qwattash/keyboard_tester/README.md

# Components for testing an early prototype RGB backlit keyboard

The design is based on the atmega32u4 MCU, found on teensey boards and arduino Leonardo boards, and an ISSI 3733 led driver that can drive leds for half of a full-size keyboard.
