qwattash/keyboard_tester/components/cherry_breakout_2u_plate.step

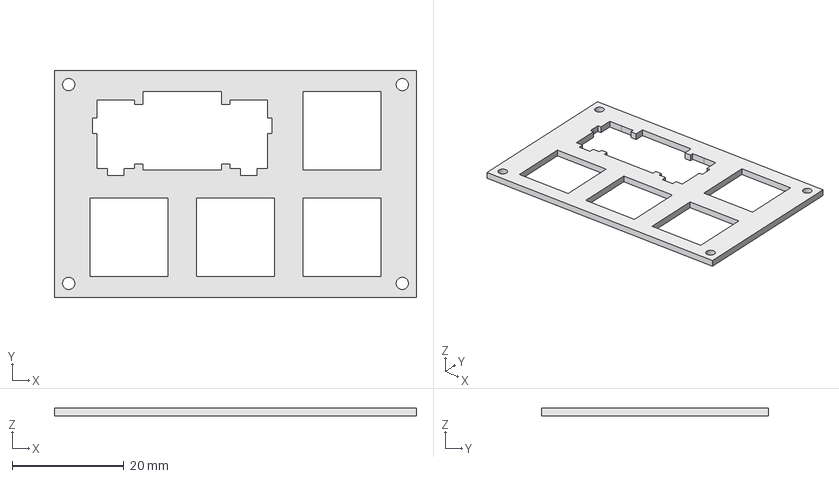
[picture p1: CAD file, 2018-07-26]
components/cherry_breakout_2u_plate.step
64.8 x 40.6 x 1.50 mm
