qwattash/keyboard_tester/(list of files, cad)

Other CAD files:
components/cherry_breakout_2u_plate.fcstd
