qwattash/keyboard_tester/pcb/cherry_proto_circuit/cherry_proto_circuit.pdf

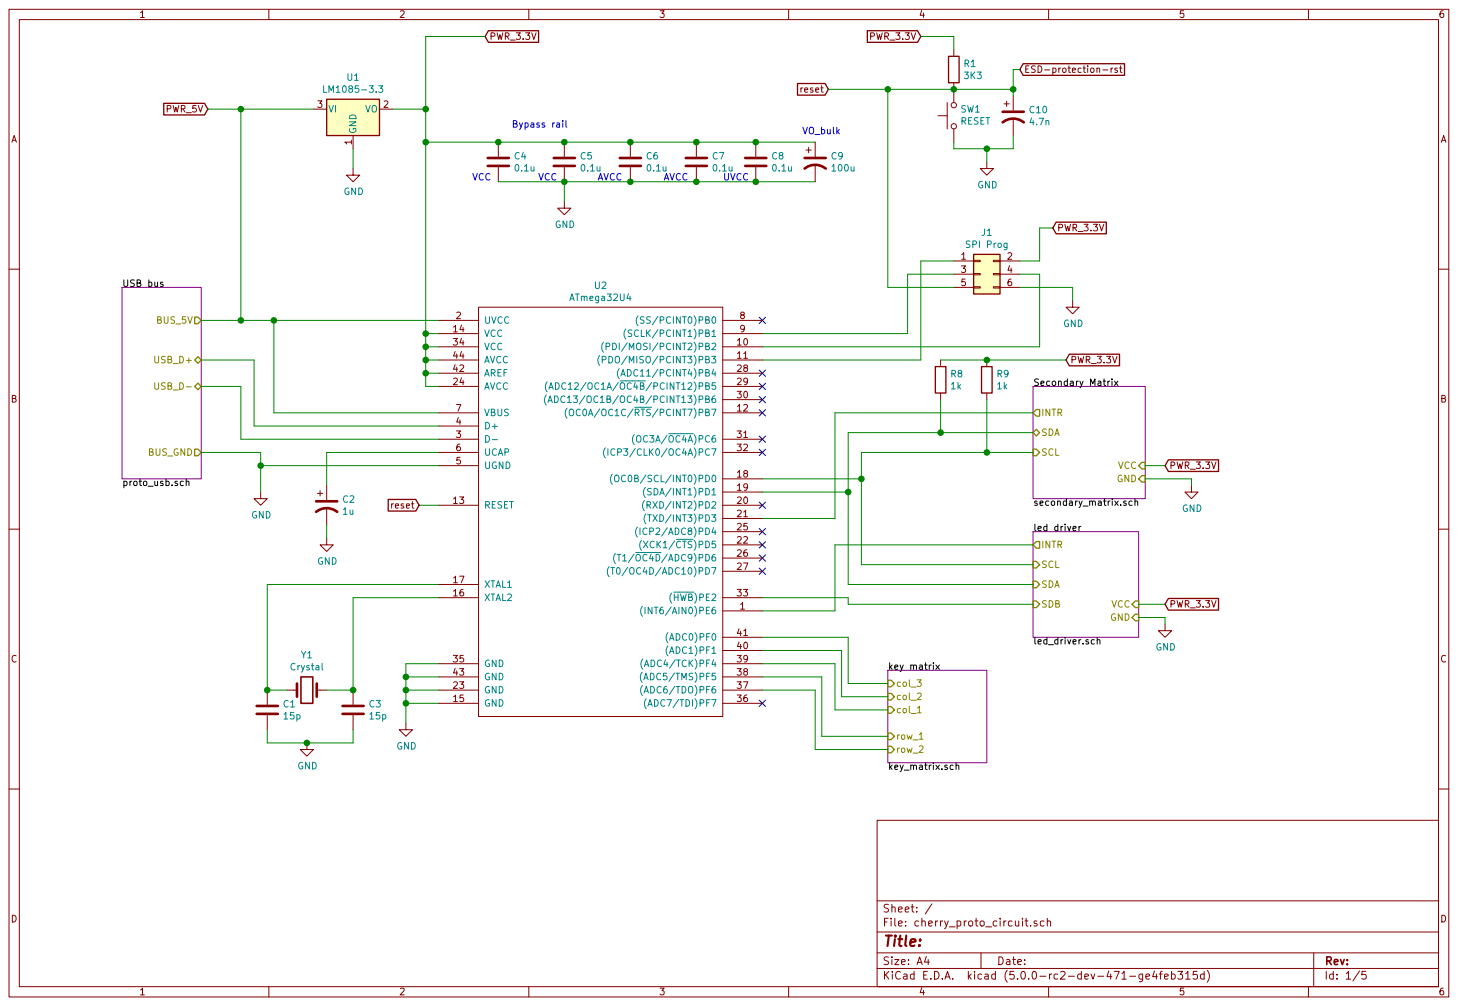
[picture p2: page 1]

Bypass rail GND GND

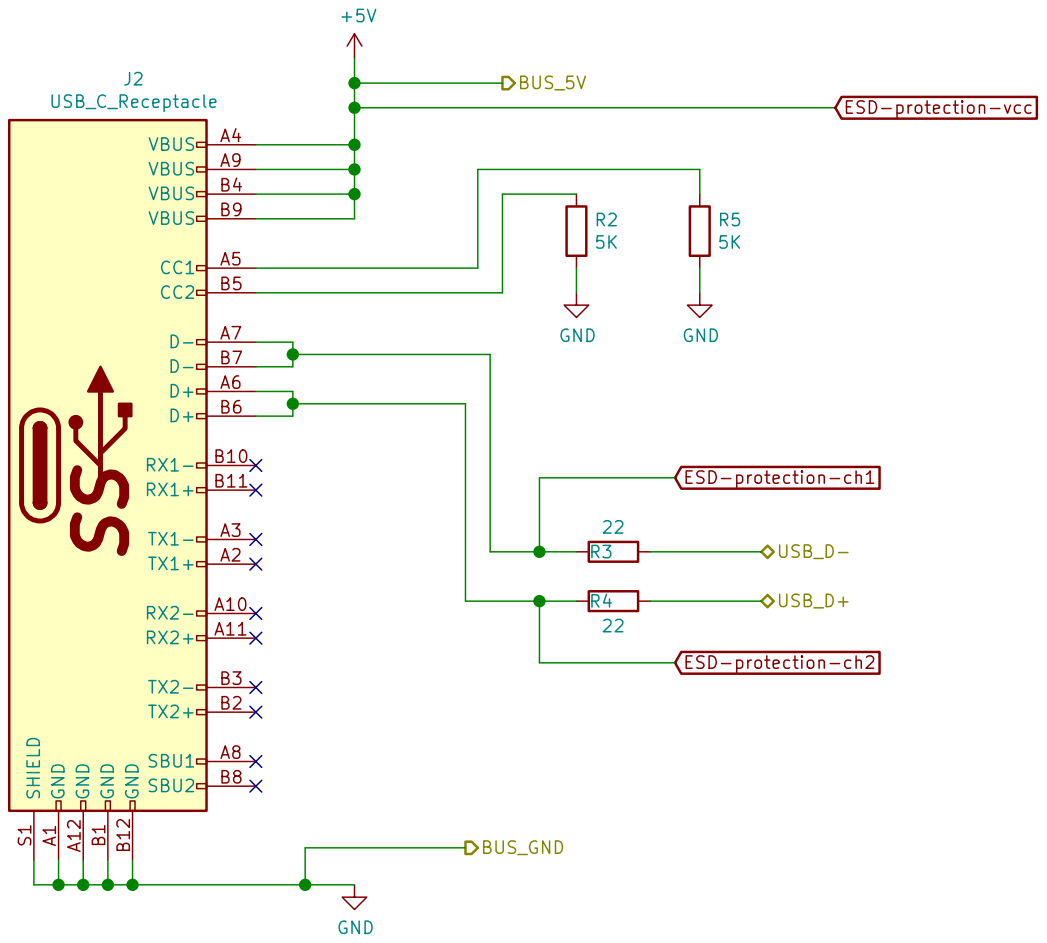
[picture p3: page 2]

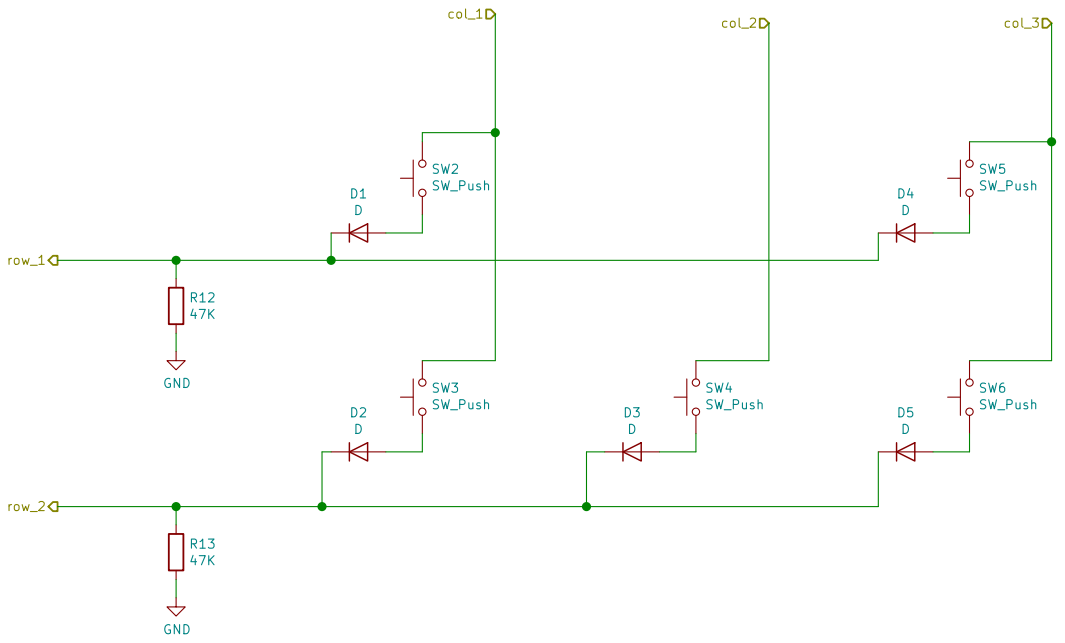
[picture p4: page 3]

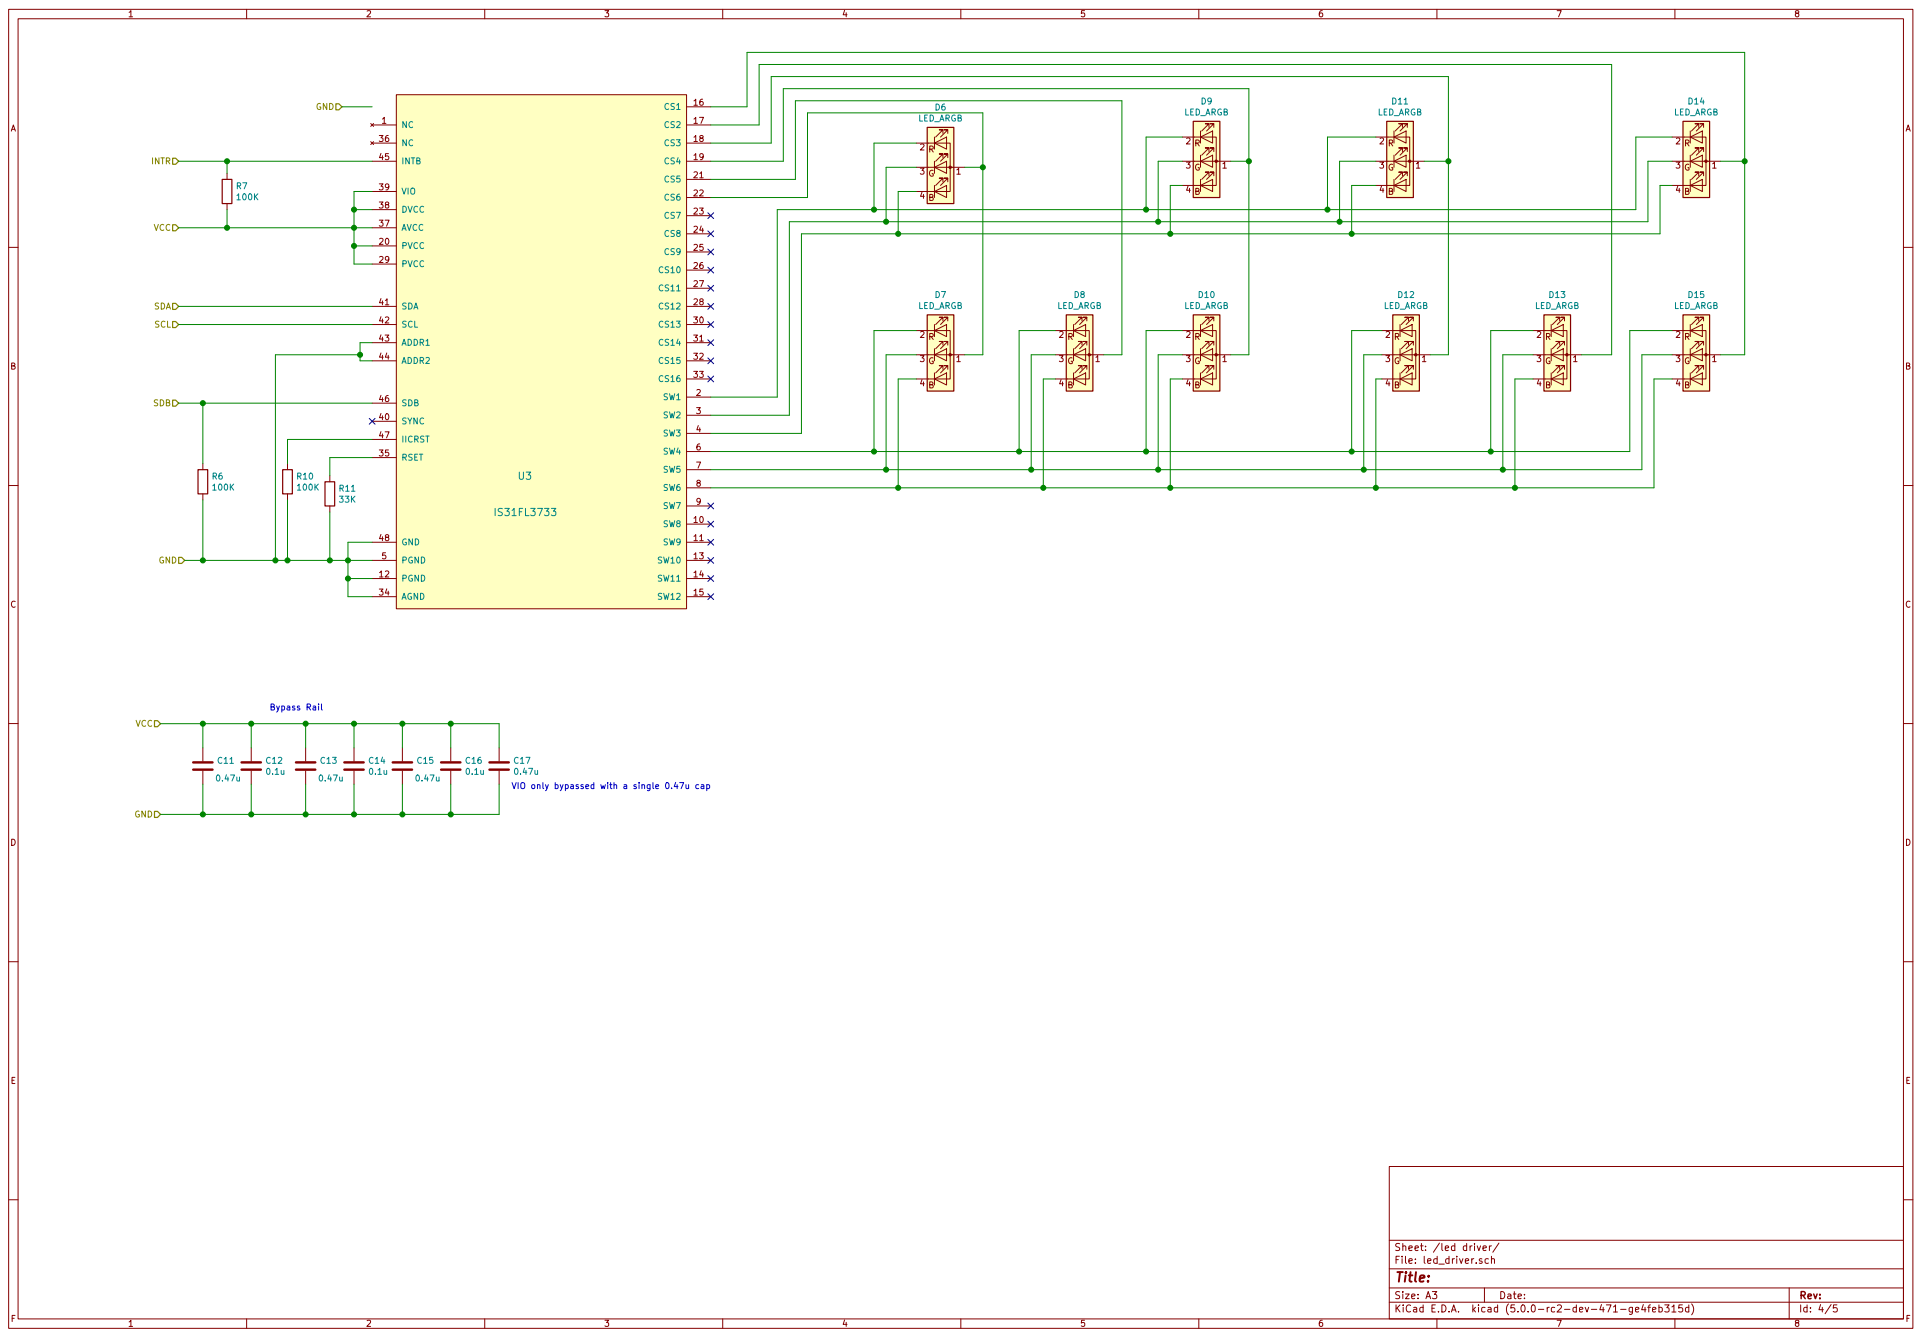
[picture p5: page 4]

Id: 4/5 Title: File: led_driver.sch Sheet: /led driver/

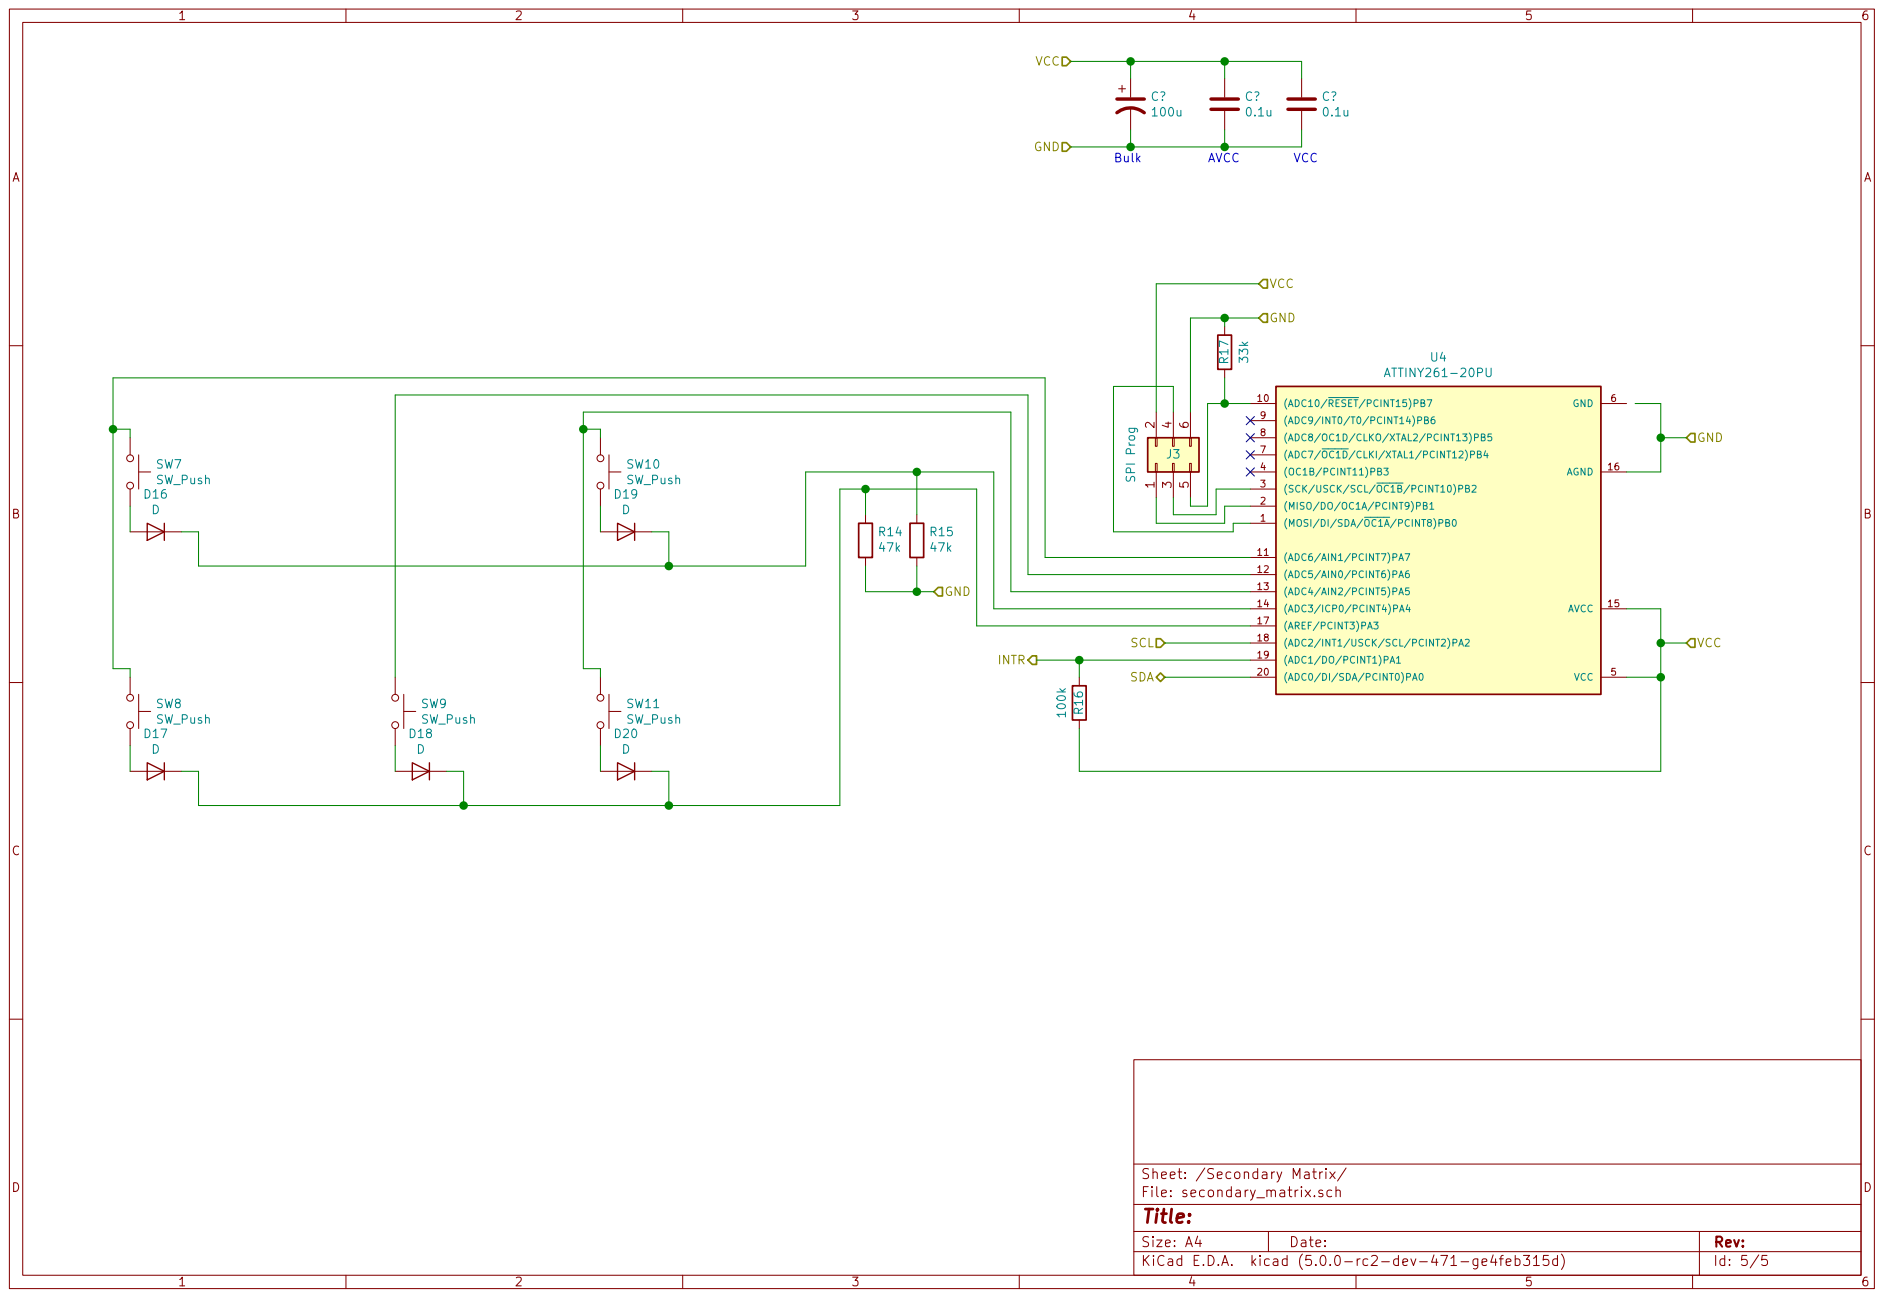
[picture p6: page 5]

Sheet: /Secondary Matrix/ SDA
