qwattash/keyboard_tester/pcb/cherry_proto_circuit/schematic.pdf

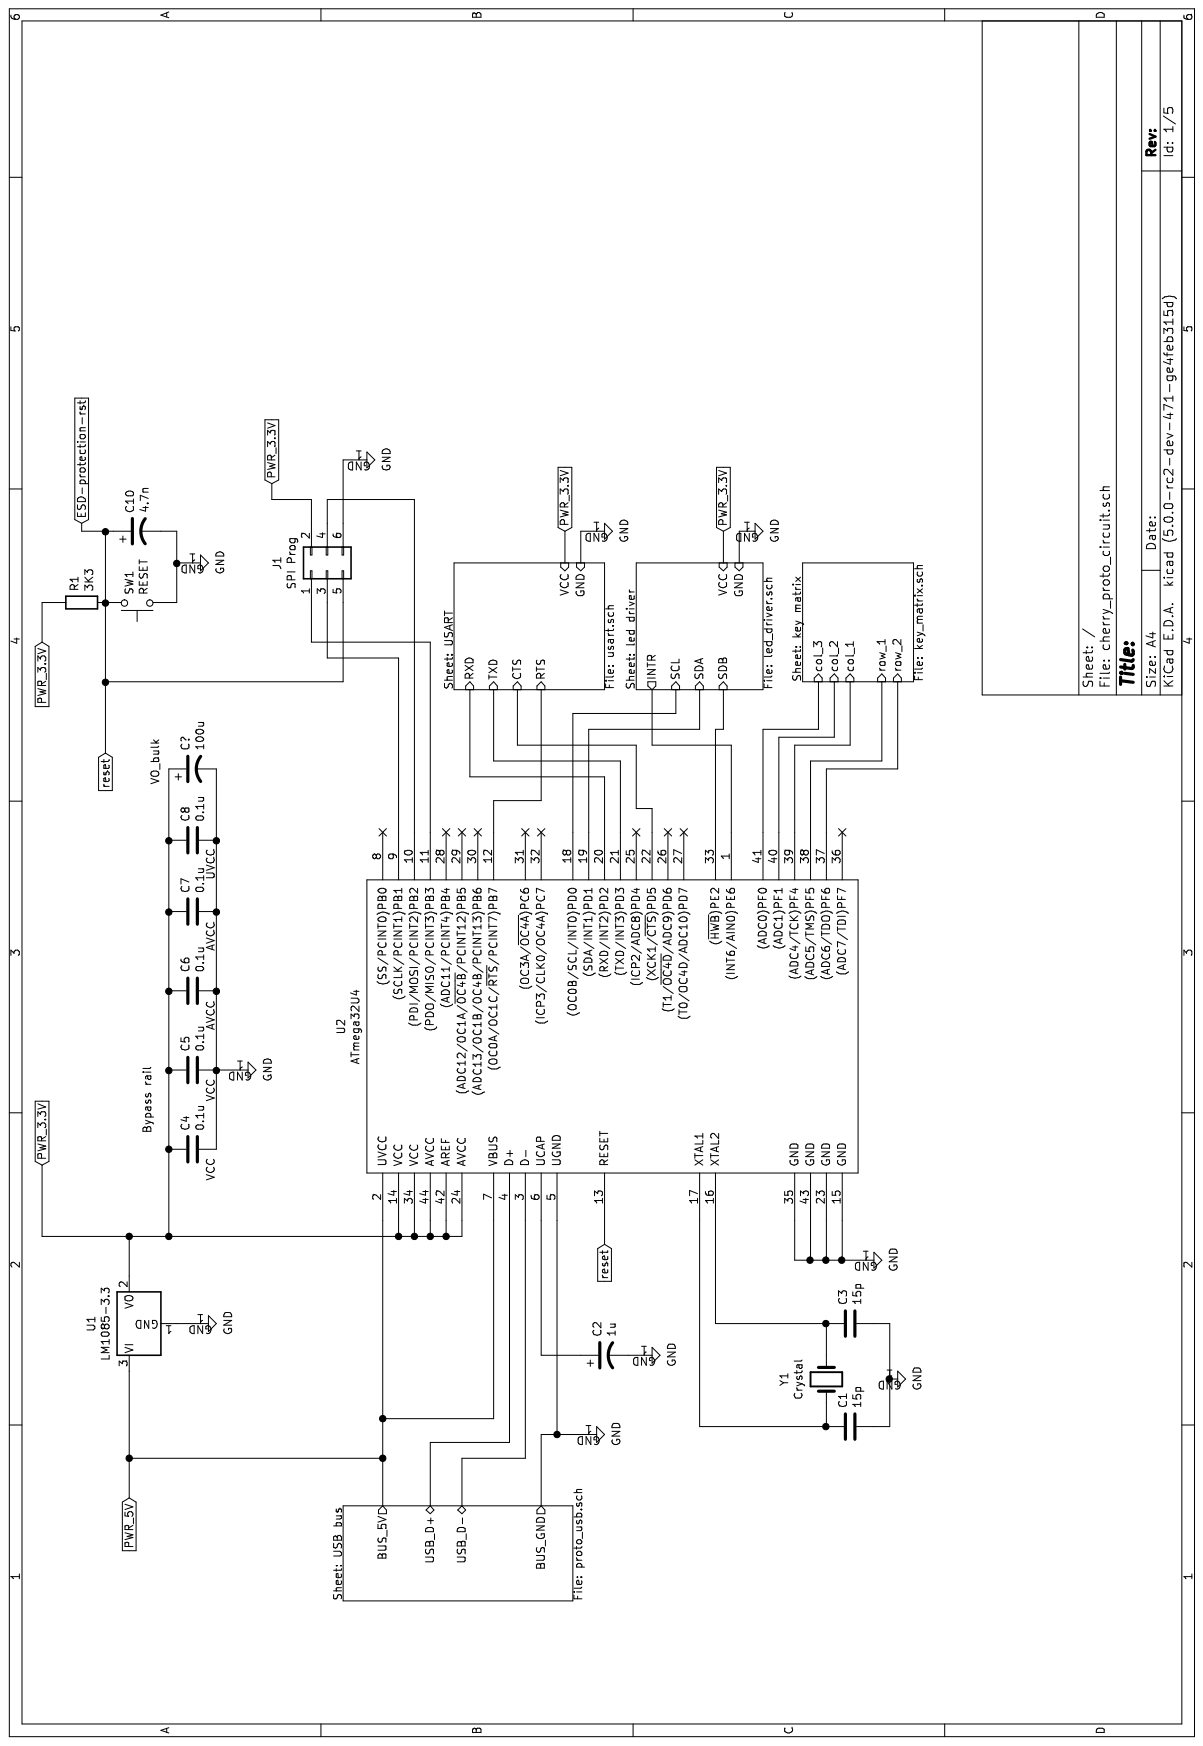
[picture p7: page 1]

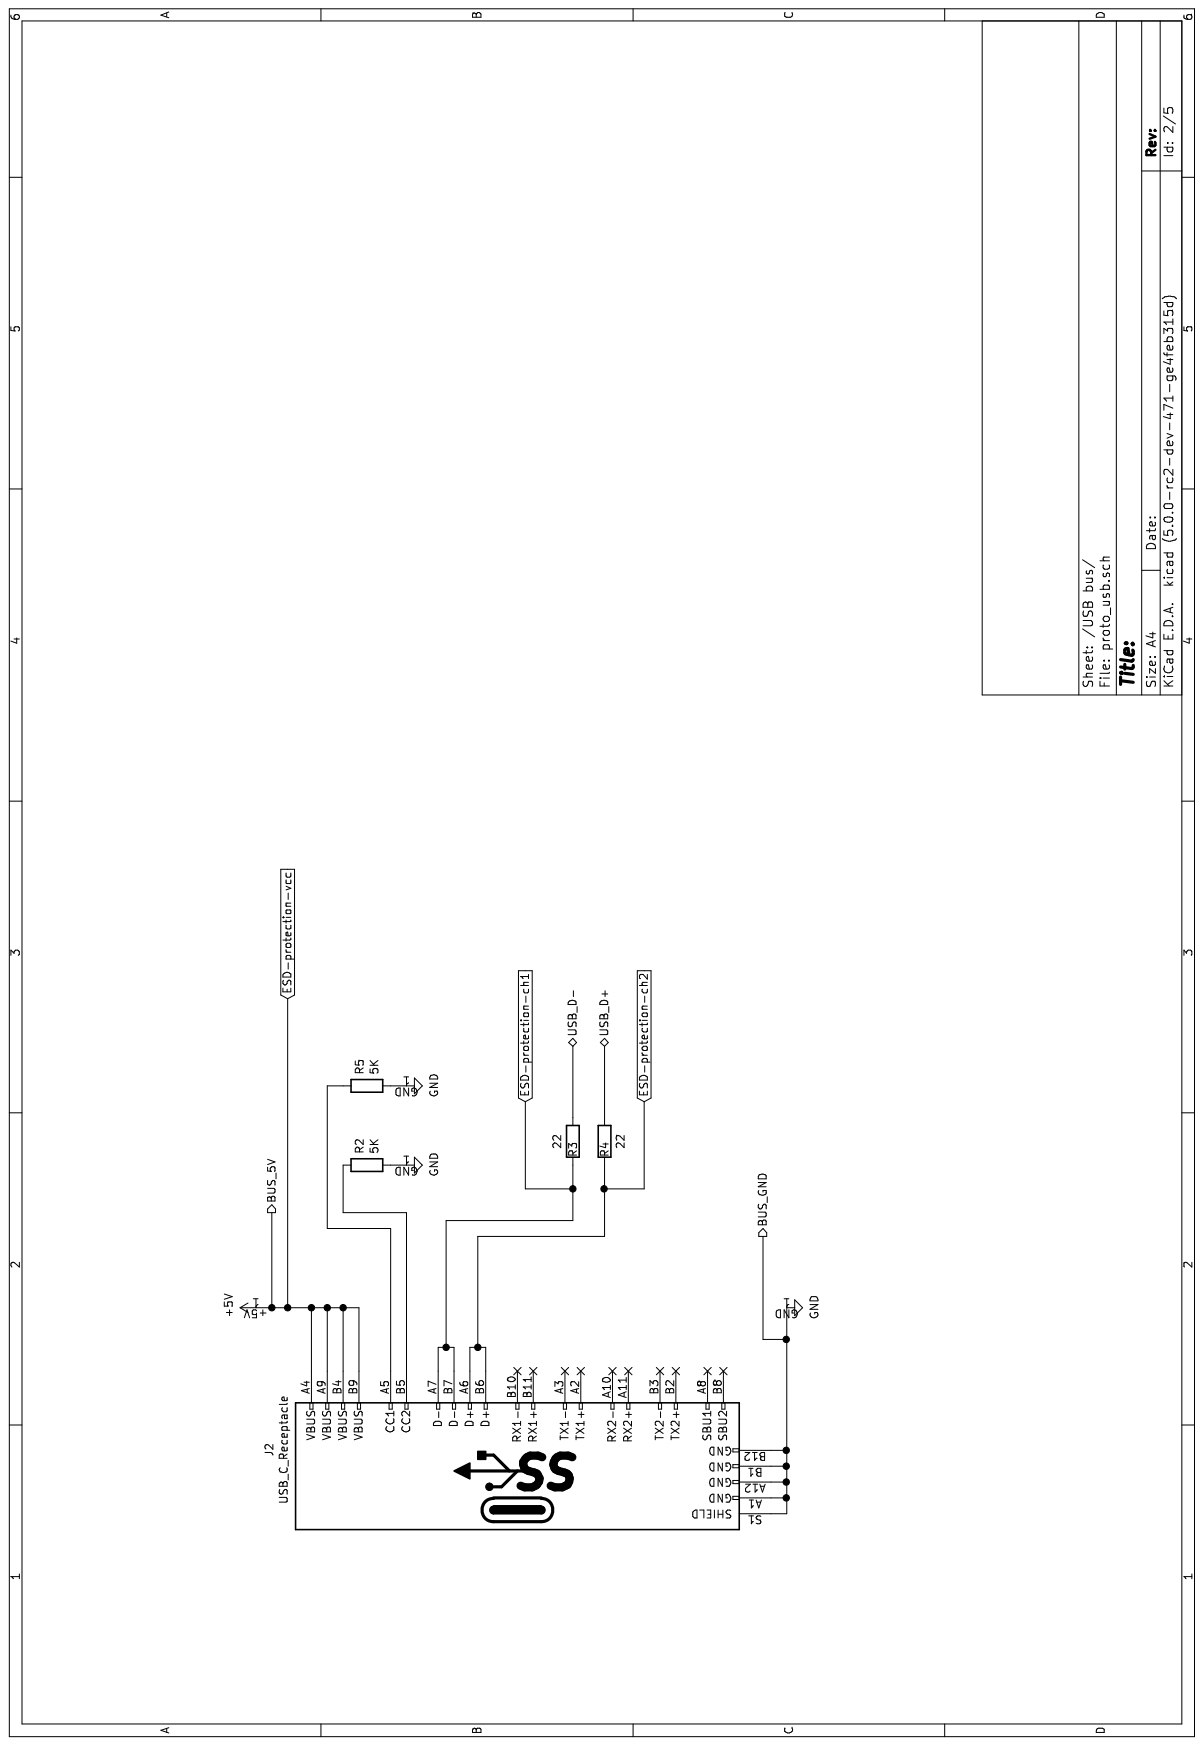
[picture p8: page 2]

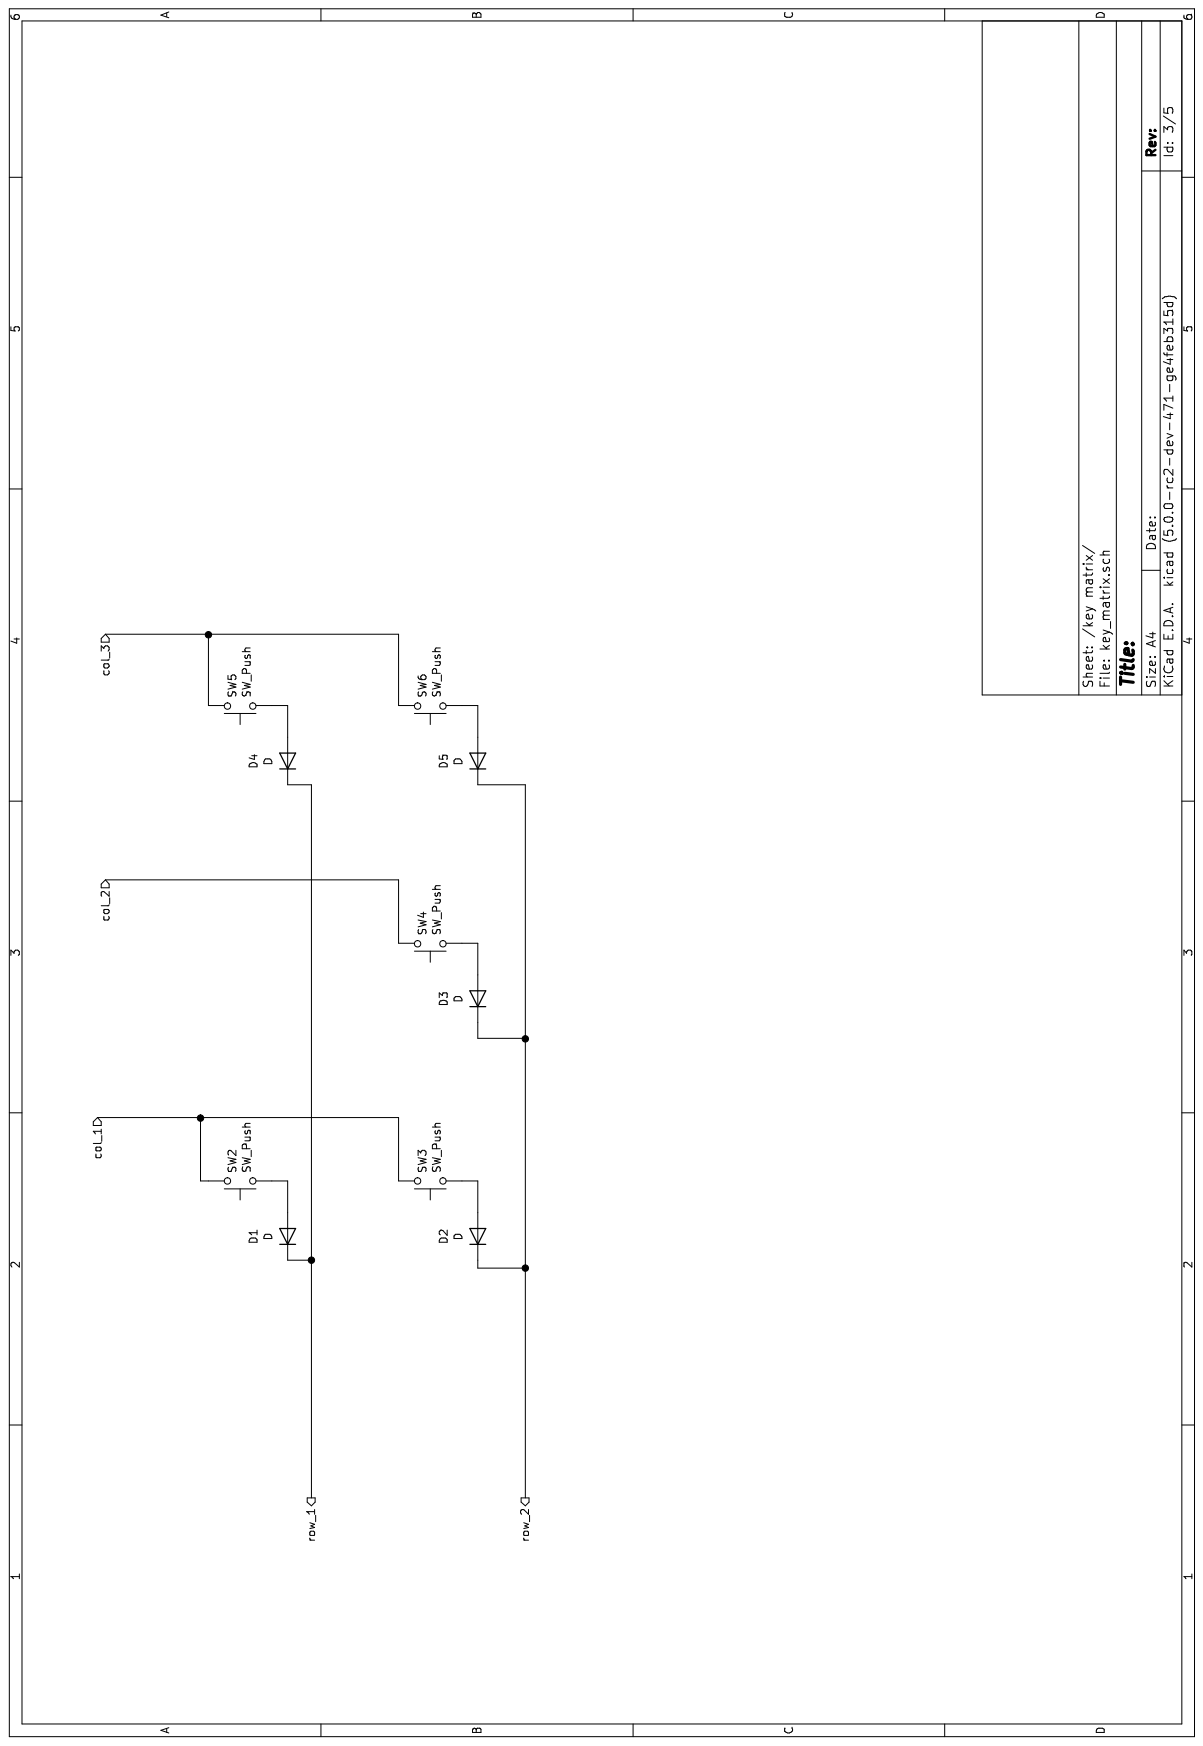
[picture p9: page 3]

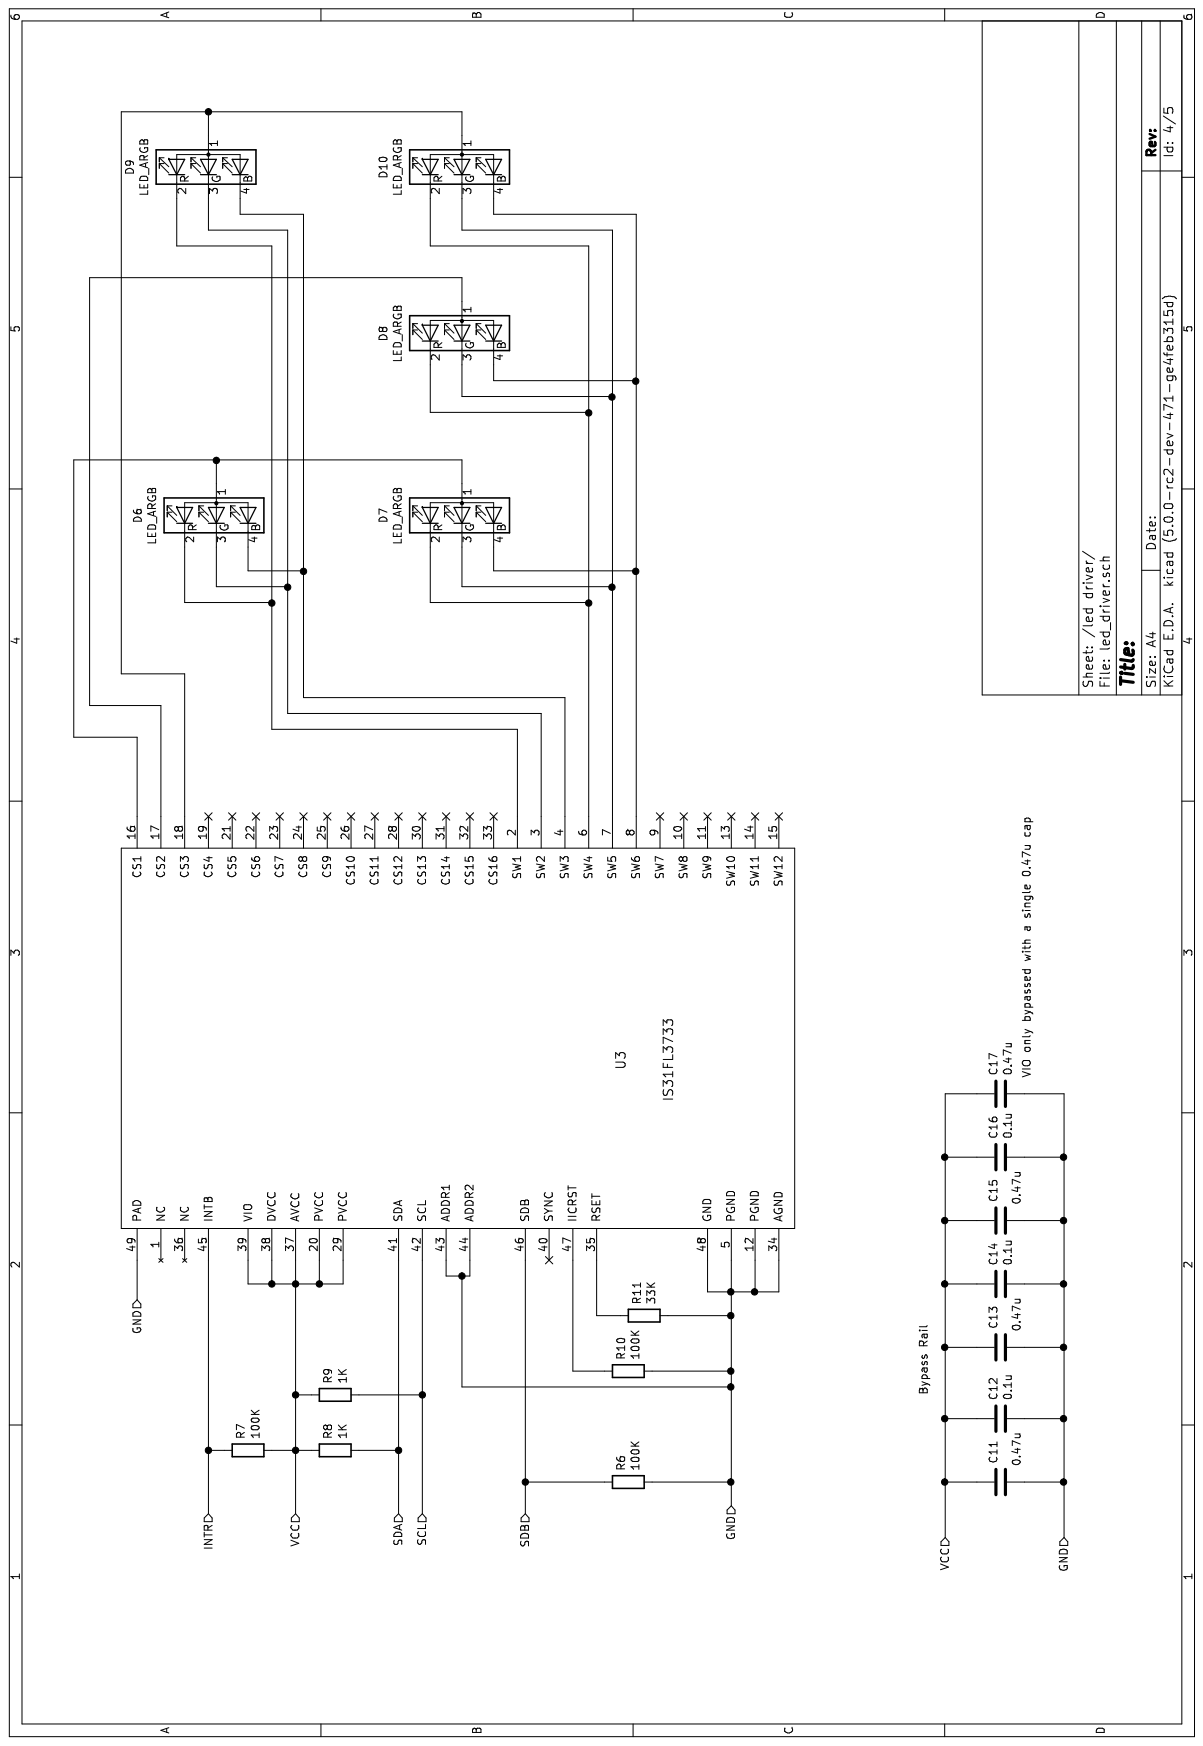
[picture p10: page 4]

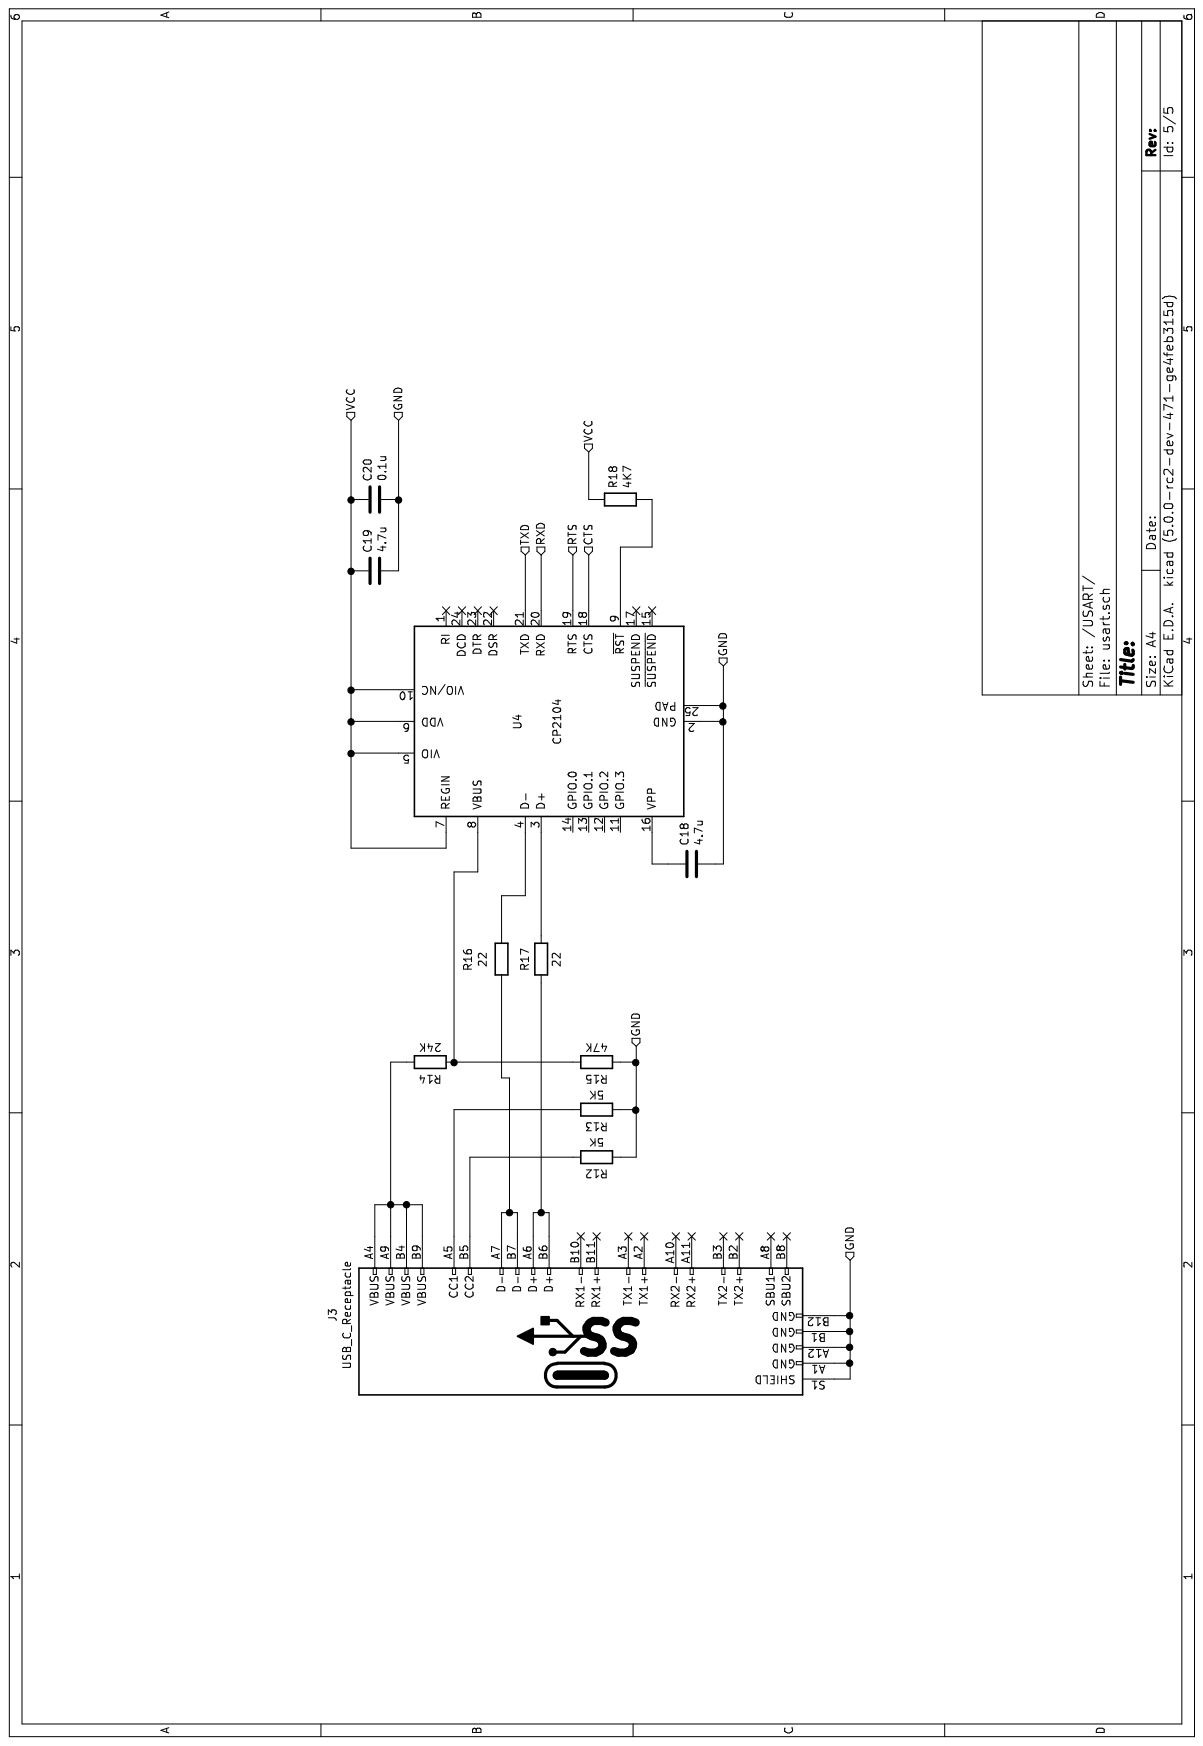
[picture p11: page 5]
