qwattash/keyboard_tester/pcb/cherry_breakout2u/cherry_breakout_2u_double_side.kicad_pcb

## KiCad design pcb/cherry_breakout2u/cherry_breakout_2u_double_side.kicad_pcb (2018-07-26)

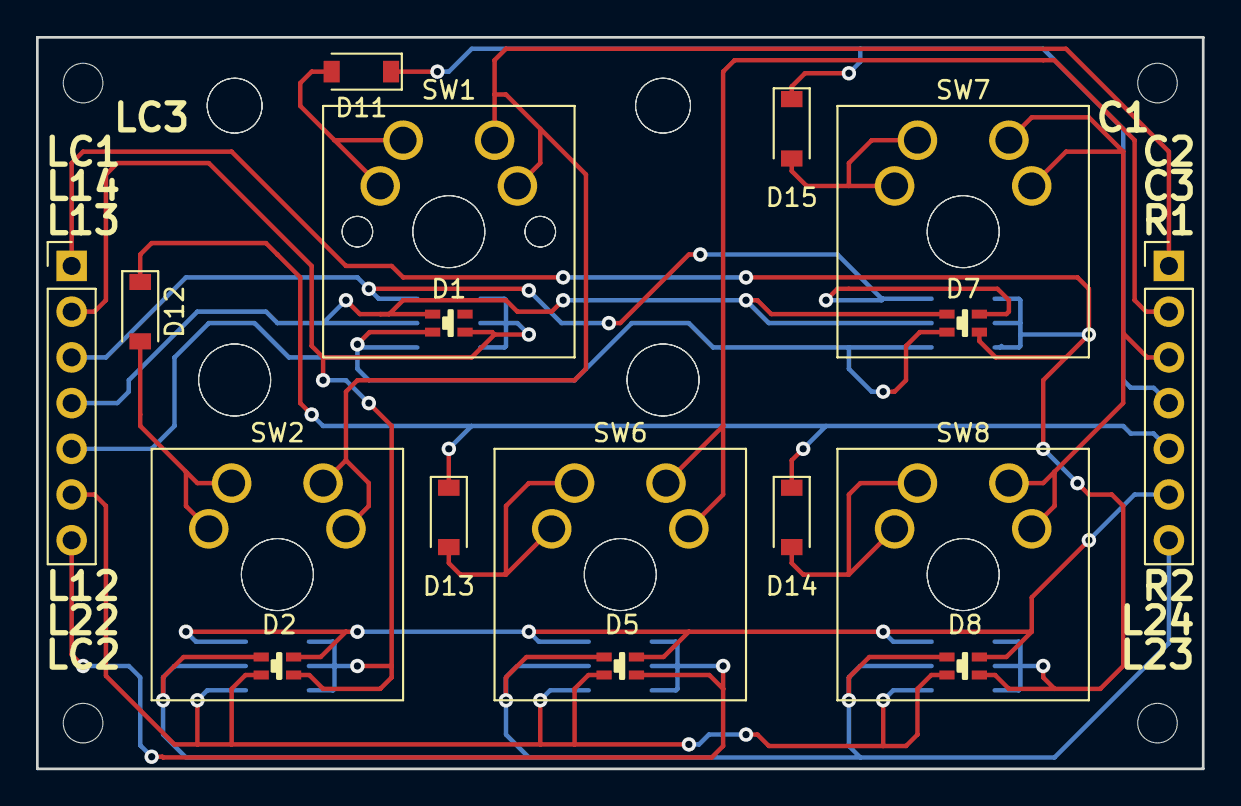
[picture p12: board cherry_breakout_2u_double_side.kicad_pcb from above]

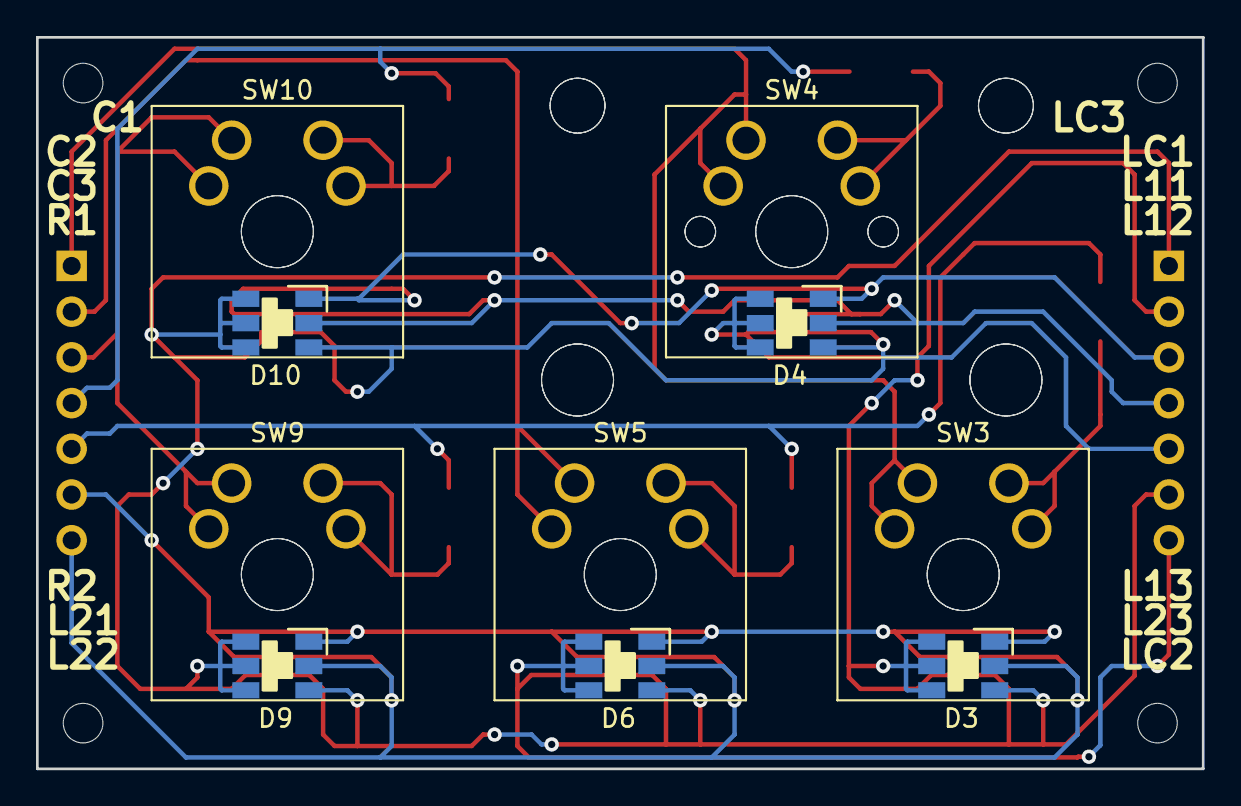
[picture p13: board cherry_breakout_2u_double_side.kicad_pcb from below]

Board: 2 copper layers, 64.8 x 40.6 mm, 27 parts (10 on the bottom side), 19 nets.

Parts:
D1: LED_A; Led_SMD_0606
D2: LED_C; Led_SMD_0606
D3: LED_Cb; LED_smd_1214
D4: LED_Ab; LED_smd_1214
D5: LED_D; Led_SMD_0606
D6: LED_Db; LED_smd_1214
D7: LED_B; Led_SMD_0606
D8: LED_E; Led_SMD_0606
D9: LED_Eb; LED_smd_1214
D10: LED_Bb; LED_smd_1214
D11: D_A; D_SOD-123
D12: D_C; D_SOD-123
D13: D_D; D_SOD-123
D14: D_E; D_SOD-123
D15: D_B; D_SOD-123
J1: ConnLeft; Pin_Header_Straight_1x07_Pitch2.54mm
J2: ConnRight; Pin_Header_Straight_1x07_Pitch2.54mm
SW1: A; SW_Cherry_MX1A_2.00u_PCB
SW2: C; SW_Cherry_MX1A_1.00u_Plate
SW3: Cb; SW_Cherry_MX1A_1.00u_Plate
SW4: Ab; SW_Cherry_MX1A_2.00u_PCB
SW5: Db; SW_Cherry_MX1A_1.00u_Plate
SW6: D; SW_Cherry_MX1A_1.00u_Plate
SW7: B; SW_Cherry_MX1A_1.00u_Plate
SW8: E; SW_Cherry_MX1A_1.00u_Plate
SW9: Eb; SW_Cherry_MX1A_1.00u_Plate
SW10: Bb; SW_Cherry_MX1A_1.00u_Plate

Connections:
unnamed: D1.1, D2.1, D3.4, D3.5, D3.6, D4.4, D4.5, D4.6, J1.2
unnamed: D1.2, D4.3, D7.2, D10.3, J1.5
unnamed: D1.3, D4.2, D7.3, D10.2, J1.4
unnamed: D1.4, D4.1, D7.4, D10.1, J1.3
unnamed: D2.2, D3.3, D5.2, D6.3, D8.2, D9.3, J1.6
unnamed: D2.3, D3.2, D5.3, D6.2, D8.3, D9.2, J2.7
unnamed: D2.4, D3.1, D5.4, D6.1, D8.4, D9.1, J2.6
unnamed: D5.1, D6.4, D6.5, D6.6, J1.7
unnamed: D7.1, D8.1, D9.4, D9.5, D9.6, D10.4, D10.5, D10.6, J1.1
unnamed: D11.1, D15.1, J2.4
unnamed: D11.2, SW1.2, SW4.1
unnamed: D12.1, D13.1, D14.1, J2.5
unnamed: D12.2, SW2.2, SW3.1
unnamed: D13.2, SW5.1, SW6.2
unnamed: D14.2, SW8.2, SW9.1
unnamed: D15.2, SW7.2, SW10.1
unnamed: J2.1, SW1.1, SW2.1, SW3.2, SW4.2
unnamed: J2.2, SW5.2, SW6.1
unnamed: J2.3, SW7.1, SW8.1, SW9.2, SW10.2
