qwattash/keyboard_tester/pcb/cherry_breakout/cherry_breakout.kicad_pcb

## KiCad design pcb/cherry_breakout/cherry_breakout.kicad_pcb (2018-07-26)

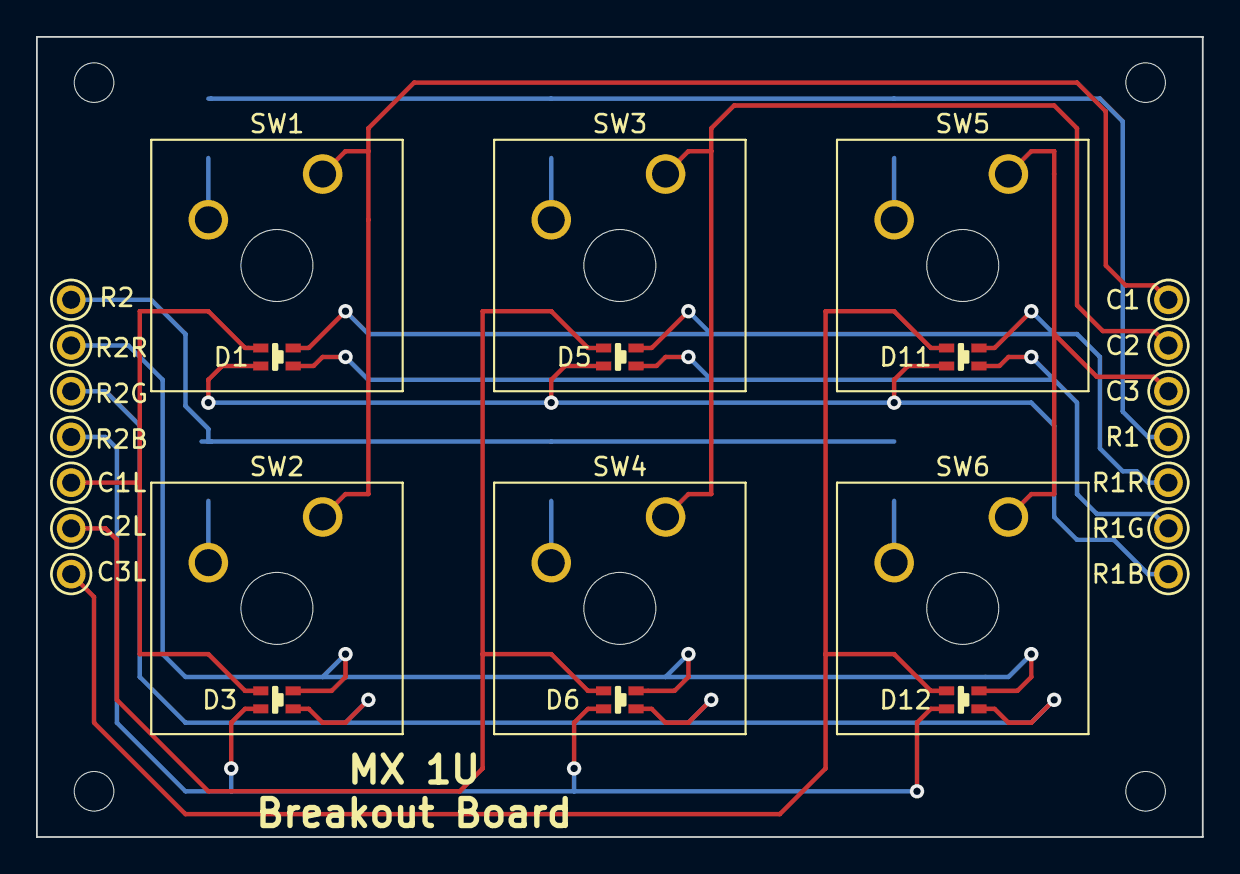
[picture p14: board cherry_breakout.kicad_pcb from above]

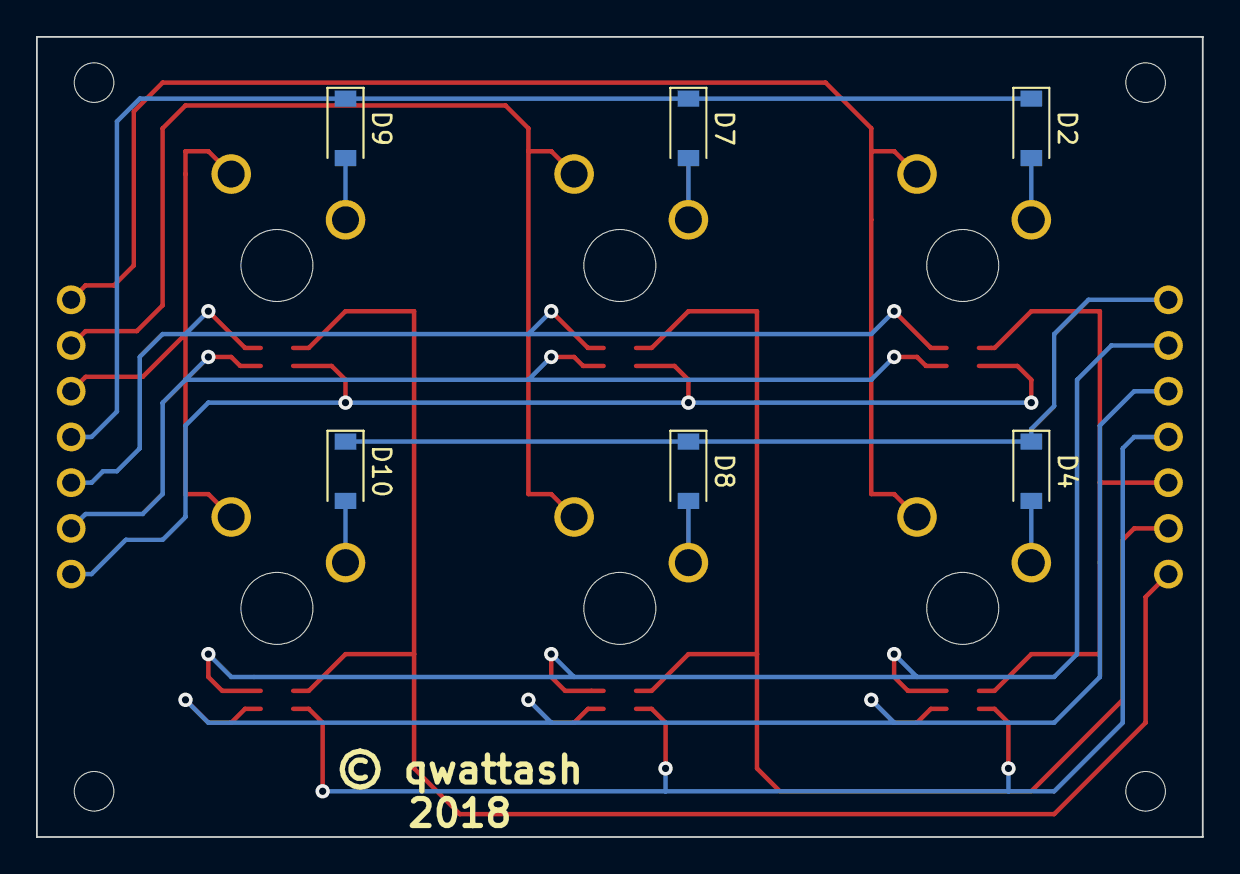
[picture p15: board cherry_breakout.kicad_pcb from below]

Board: 2 copper layers, 64.8 x 44.5 mm, 32 parts (6 on the bottom side), 20 nets.

Parts:
C1: Col1; Connector_Via_1.0mm
C1L: LCol1; Connector_Via_1.0mm
C2: Col2; Connector_Via_1.0mm
C2L: LCol2; Connector_Via_1.0mm
C3: Col3; Connector_Via_1.0mm
C3L: LCol3; Connector_Via_1.0mm
D1: LED_11; Led_SMD_0606
D2, D4, D7, D8, D9, D10: D_ALT; D_SOD-123
D3: LED_21; Led_SMD_0606
D5: LED_12; Led_SMD_0606
D6: LED_22; Led_SMD_0606
D11: LED_13; Led_SMD_0606
D12: LED_23; Led_SMD_0606
R1: Row 1; Connector_Via_1.0mm
R1B: LRow1B; Connector_Via_1.0mm
R1G: LRow1G; Connector_Via_1.0mm
R1R: LRow1R; Connector_Via_1.0mm
R2: Row 2; Connector_Via_1.0mm
R2B: LRow2B; Connector_Via_1.0mm
R2G: LRow2G; Connector_Via_1.0mm
R2R: LRow2R; Connector_Via_1.0mm
SW1: SW11; SW_Cherry_MX1A_1.00u_Plate
SW2: SW21; SW_Cherry_MX1A_1.00u_Plate
SW3: SW12; SW_Cherry_MX1A_1.00u_Plate
SW4: SW22; SW_Cherry_MX1A_1.00u_Plate
SW5: SW13; SW_Cherry_MX1A_1.00u_Plate
SW6: SW23; SW_Cherry_MX1A_1.00u_Plate

Connections:
unnamed: C1L.1, D1.1, D3.1
unnamed: D1.2, D5.2, D11.2, R1R.1
unnamed: D1.3, D5.3, D11.3, R1G.1
unnamed: D1.4, D5.4, D11.4, R1B.1
unnamed: D2.1, D7.1, D9.1, R1.1
unnamed: D2.2, SW1.2
unnamed: D4.2, SW2.2
unnamed: C2L.1, D5.1, D6.1
unnamed: D7.2, SW3.2
unnamed: D8.2, SW4.2
unnamed: D9.2, SW5.2
unnamed: D4.1, D8.1, D10.1, R2.1
unnamed: D10.2, SW6.2
unnamed: C3L.1, D11.1, D12.1
unnamed: D3.2, D6.2, D12.2, R2R.1
unnamed: D3.3, D6.3, D12.3, R2G.1
unnamed: D3.4, D6.4, D12.4, R2B.1
unnamed: C1.1, SW1.1, SW2.1
unnamed: C2.1, SW3.1, SW4.1
unnamed: C3.1, SW5.1, SW6.1
