qwattash/keyboard_tester/pcb/tqfp44-48_breakout/tqfp44-48_breakout.kicad_pcb

## KiCad design pcb/tqfp44-48_breakout/tqfp44-48_breakout.kicad_pcb (2018-07-26)

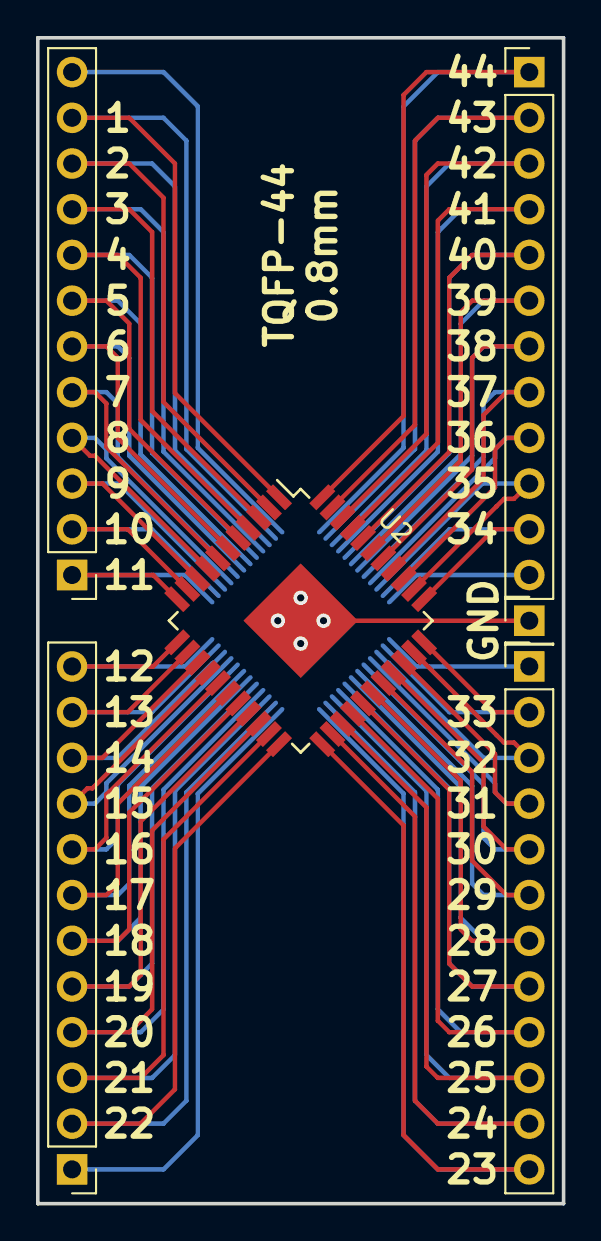
[picture p16: board tqfp44-48_breakout.kicad_pcb from above]

Board: 2 copper layers, 29.2 x 64.8 mm, 7 parts (1 on the bottom side), 49 nets.

Parts:
J1, J2, J3, J4: Conn_01x12; Pin_Header_Straight_1x12_Pitch2.54mm
J5: Conn_01x01; Pin_Header_Straight_1x01_Pitch2.54mm
U1: Generic_48pin_with_pad; TQFP-48-1EP_7x7mm_Pitch0.5mm
U2: Generic_44pin_with_pad; TQFP-44-1EP_10x10mm_Pitch0.8mm

Connections:
GND: J5.1, U1.49, U2.45
unnamed: J1.1, U1.37
unnamed: J1.2, U1.38, U2.22
unnamed: J1.3, U1.39, U2.21
unnamed: J1.4, U1.40, U2.20
unnamed: J1.5, U1.41, U2.19
unnamed: J1.6, U1.42, U2.18
unnamed: J1.7, U1.43, U2.17
unnamed: J1.8, U1.44, U2.16
unnamed: J1.9, U1.45, U2.15
unnamed: J1.10, U1.46, U2.14
unnamed: J1.11, U1.47, U2.13
unnamed: J1.12, U1.48, U2.12
unnamed: J2.1, U1.1, U2.11
unnamed: J2.2, U1.2, U2.10
unnamed: J2.3, U1.3, U2.9
unnamed: J2.4, U1.4, U2.8
unnamed: J2.5, U1.5, U2.7
unnamed: J2.6, U1.6, U2.6
unnamed: J2.7, U1.7, U2.5
unnamed: J2.8, U1.8, U2.4
unnamed: J2.9, U1.9, U2.3
unnamed: J2.10, U1.10, U2.2
unnamed: J2.11, U1.11, U2.1
unnamed: J2.12, U1.12
unnamed: J3.1, U1.25
unnamed: J3.2, U1.26, U2.33
unnamed: J3.3, U1.27, U2.32
unnamed: J3.4, U1.28, U2.31
unnamed: J3.5, U1.29, U2.30
unnamed: J3.6, U1.30, U2.29
unnamed: J3.7, U1.31, U2.28
unnamed: J3.8, U1.32, U2.27
unnamed: J3.9, U1.33, U2.26
unnamed: J3.10, U1.34, U2.25
unnamed: J3.11, U1.35, U2.24
unnamed: J3.12, U1.36, U2.23
unnamed: J4.1, U1.13, U2.44
unnamed: J4.2, U1.14, U2.43
unnamed: J4.3, U1.15, U2.42
unnamed: J4.4, U1.16, U2.41
unnamed: J4.5, U1.17, U2.40
unnamed: J4.6, U1.18, U2.39
unnamed: J4.7, U1.19, U2.38
unnamed: J4.8, U1.20, U2.37
unnamed: J4.9, U1.21, U2.36
unnamed: J4.10, U1.22, U2.35
unnamed: J4.11, U1.23, U2.34
unnamed: J4.12, U1.24
