qwattash/keyboard_tester/pcb/panel/panel.kicad_pcb

## KiCad design pcb/panel/panel.kicad_pcb (2018-07-26)

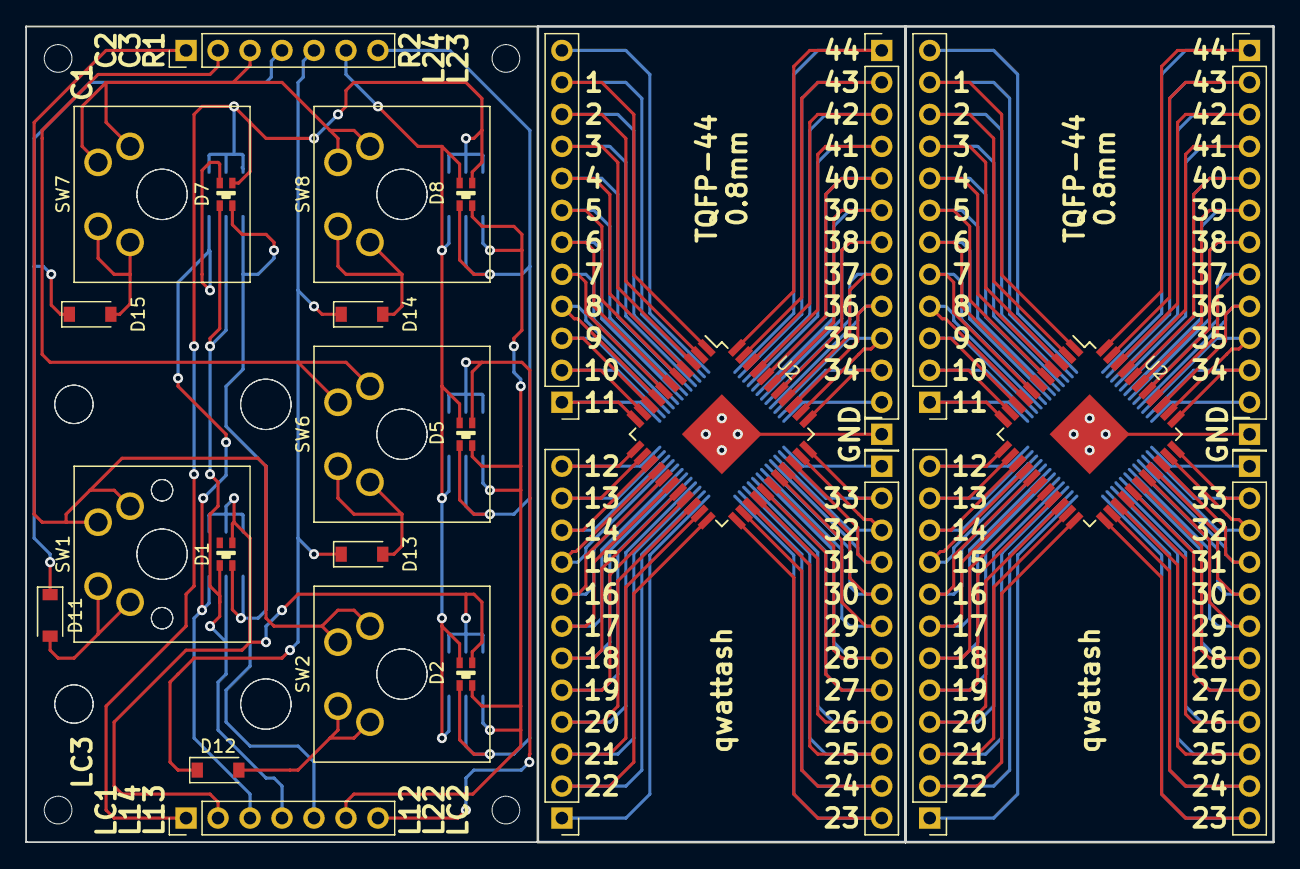
[picture p17: board panel.kicad_pcb from above]

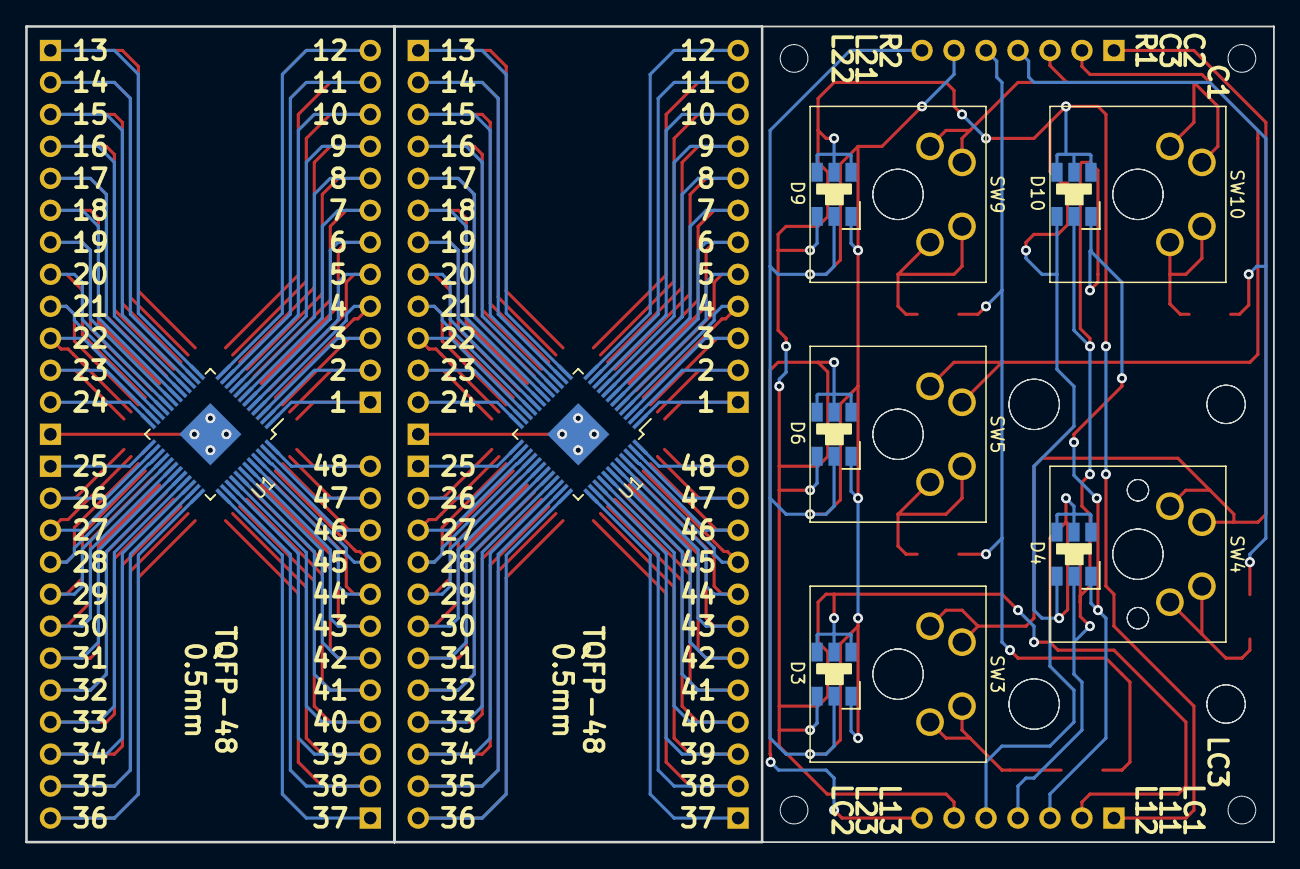
[picture p18: board panel.kicad_pcb from below]

Board: 2 copper layers, 99.1 x 64.8 mm, 41 parts (12 on the bottom side), 65 nets.

Parts:
D1: LED_A; Led_SMD_0606
D2: LED_C; Led_SMD_0606
D3: LED_Cb; LED_smd_1214
D4: LED_Ab; LED_smd_1214
D5: LED_D; Led_SMD_0606
D6: LED_Db; LED_smd_1214
D7: LED_B; Led_SMD_0606
D8: LED_E; Led_SMD_0606
D9: LED_Eb; LED_smd_1214
D10: LED_Bb; LED_smd_1214
D11: D_A; D_SOD-123
D12: D_C; D_SOD-123
D13: D_D; D_SOD-123
D14: D_E; D_SOD-123
D15: D_B; D_SOD-123
J1, J1#2, J2, J2#2, J3, J3#2, J4, J4#2: Conn_01x12; Pin_Header_Straight_1x12_Pitch2.54mm
J1#3: ConnLeft; Pin_Header_Straight_1x07_Pitch2.54mm
J2#3: ConnRight; Pin_Header_Straight_1x07_Pitch2.54mm
J5, J5#2: Conn_01x01; Pin_Header_Straight_1x01_Pitch2.54mm
SW1: A; SW_Cherry_MX1A_2.00u_PCB
SW2: C; SW_Cherry_MX1A_1.00u_Plate
SW3: Cb; SW_Cherry_MX1A_1.00u_Plate
SW4: Ab; SW_Cherry_MX1A_2.00u_PCB
SW5: Db; SW_Cherry_MX1A_1.00u_Plate
SW6: D; SW_Cherry_MX1A_1.00u_Plate
SW7: B; SW_Cherry_MX1A_1.00u_Plate
SW8: E; SW_Cherry_MX1A_1.00u_Plate
SW9: Eb; SW_Cherry_MX1A_1.00u_Plate
SW10: Bb; SW_Cherry_MX1A_1.00u_Plate
U1, U1#2: Generic_48pin_with_pad; TQFP-48-1EP_7x7mm_Pitch0.5mm
U2, U2#2: Generic_44pin_with_pad; TQFP-44-1EP_10x10mm_Pitch0.8mm

Connections:
GND: J5.1, J5#2.1, U1.49, U1#2.49, U2.45, U2#2.45
unnamed: D1.1, D2.1, D3.4, D3.5, D3.6, D4.4, D4.5, D4.6, J1#3.2
unnamed: D1.2, D4.3, D7.2, D10.3, J1#3.5
unnamed: D1.3, D4.2, D7.3, D10.2, J1#3.4
unnamed: D1.4, D4.1, D7.4, D10.1, J1#3.3
unnamed: D2.2, D3.3, D5.2, D6.3, D8.2, D9.3, J1#3.6
unnamed: D2.3, D3.2, D5.3, D6.2, D8.3, D9.2, J2#3.7
unnamed: D2.4, D3.1, D5.4, D6.1, D8.4, D9.1, J2#3.6
unnamed: D5.1, D6.4, D6.5, D6.6, J1#3.7
unnamed: D7.1, D8.1, D9.4, D9.5, D9.6, D10.4, D10.5, D10.6, J1#3.1
unnamed: D11.1, D15.1, J2#3.4
unnamed: D11.2, SW1.2, SW4.1
unnamed: D12.1, D13.1, D14.1, J2#3.5
unnamed: D12.2, SW2.2, SW3.1
unnamed: D13.2, SW5.1, SW6.2
unnamed: D14.2, SW8.2, SW9.1
unnamed: D15.2, SW7.2, SW10.1
unnamed: J1.1, J1#2.1, U1.37, U1#2.37
unnamed: J1.2, J1#2.2, U1.38, U1#2.38, U2.22, U2#2.22
unnamed: J1.3, J1#2.3, U1.39, U1#2.39, U2.21, U2#2.21
unnamed: J1.4, J1#2.4, U1.40, U1#2.40, U2.20, U2#2.20
unnamed: J1.5, J1#2.5, U1.41, U1#2.41, U2.19, U2#2.19
unnamed: J1.6, J1#2.6, U1.42, U1#2.42, U2.18, U2#2.18
unnamed: J1.7, J1#2.7, U1.43, U1#2.43, U2.17, U2#2.17
unnamed: J1.8, J1#2.8, U1.44, U1#2.44, U2.16, U2#2.16
unnamed: J1.9, J1#2.9, U1.45, U1#2.45, U2.15, U2#2.15
unnamed: J1.10, J1#2.10, U1.46, U1#2.46, U2.14, U2#2.14
unnamed: J1.11, J1#2.11, U1.47, U1#2.47, U2.13, U2#2.13
unnamed: J1.12, J1#2.12, U1.48, U1#2.48, U2.12, U2#2.12
unnamed: J2.1, J2#2.1, J2#3.1, SW1.1, SW2.1, SW3.2, SW4.2, U1.1, U1#2.1, U2.11, U2#2.11
unnamed: J2.2, J2#2.2, J2#3.2, SW5.2, SW6.1, U1.2, U1#2.2, U2.10, U2#2.10
unnamed: J2.3, J2#2.3, J2#3.3, SW7.1, SW8.1, SW9.2, SW10.2, U1.3, U1#2.3, U2.9, U2#2.9
unnamed: J2.4, J2#2.4, U1.4, U1#2.4, U2.8, U2#2.8
unnamed: J2.5, J2#2.5, U1.5, U1#2.5, U2.7, U2#2.7
unnamed: J2.6, J2#2.6, U1.6, U1#2.6, U2.6, U2#2.6
unnamed: J2.7, J2#2.7, U1.7, U1#2.7, U2.5, U2#2.5
unnamed: J2.8, J2#2.8, U1.8, U1#2.8, U2.4, U2#2.4
unnamed: J2.9, J2#2.9, U1.9, U1#2.9, U2.3, U2#2.3
unnamed: J2.10, J2#2.10, U1.10, U1#2.10, U2.2, U2#2.2
unnamed: J2.11, J2#2.11, U1.11, U1#2.11, U2.1, U2#2.1
unnamed: J2.12, J2#2.12, U1.12, U1#2.12
unnamed: J3.1, J3#2.1, U1.25, U1#2.25
unnamed: J3.2, J3#2.2, U1.26, U1#2.26, U2.33, U2#2.33
unnamed: J3.3, J3#2.3, U1.27, U1#2.27, U2.32, U2#2.32
unnamed: J3.4, J3#2.4, U1.28, U1#2.28, U2.31, U2#2.31
unnamed: J3.5, J3#2.5, U1.29, U1#2.29, U2.30, U2#2.30
unnamed: J3.6, J3#2.6, U1.30, U1#2.30, U2.29, U2#2.29
unnamed: J3.7, J3#2.7, U1.31, U1#2.31, U2.28, U2#2.28
unnamed: J3.8, J3#2.8, U1.32, U1#2.32, U2.27, U2#2.27
unnamed: J3.9, J3#2.9, U1.33, U1#2.33, U2.26, U2#2.26
unnamed: J3.10, J3#2.10, U1.34, U1#2.34, U2.25, U2#2.25
unnamed: J3.11, J3#2.11, U1.35, U1#2.35, U2.24, U2#2.24
unnamed: J3.12, J3#2.12, U1.36, U1#2.36, U2.23, U2#2.23
unnamed: J4.1, J4#2.1, U1.13, U1#2.13, U2.44, U2#2.44
unnamed: J4.2, J4#2.2, U1.14, U1#2.14, U2.43, U2#2.43
unnamed: J4.3, J4#2.3, U1.15, U1#2.15, U2.42, U2#2.42
unnamed: J4.4, J4#2.4, U1.16, U1#2.16, U2.41, U2#2.41
unnamed: J4.5, J4#2.5, U1.17, U1#2.17, U2.40, U2#2.40
unnamed: J4.6, J4#2.6, U1.18, U1#2.18, U2.39, U2#2.39
unnamed: J4.7, J4#2.7, U1.19, U1#2.19, U2.38, U2#2.38
unnamed: J4.8, J4#2.8, U1.20, U1#2.20, U2.37, U2#2.37
unnamed: J4.9, J4#2.9, U1.21, U1#2.21, U2.36, U2#2.36
unnamed: J4.10, J4#2.10, U1.22, U1#2.22, U2.35, U2#2.35
unnamed: J4.11, J4#2.11, U1.23, U1#2.23, U2.34, U2#2.34
unnamed: J4.12, J4#2.12, U1.24, U1#2.24
