qwattash/keyboard_tester/(commit log)

2018-07-29 Remove arduino-cmake since we are not going to use any arduino stuff. Add lufa submodule.
2018-11-21 Add pull-down resistors on keyboard rows.
    [key_matrix.sch, led_driver.sch]
2018-12-01 Move keyboard matrix handling to a separate source file.
    This operates the keyboard scanning loop with the main timer.
    The keyboard record will be fed from the matrix scanning loop, this
    makes it easier to integrate a secondary matrix scanning input over TWI
    at a later point.
2018-12-06 Add secondary keyboard matrix to the schematic.
    The secondary matrix is driven by an ATTiny x61 which has the advantage of
    having I2C pins separate from the SPI programming pins, this makes it easier
    to program it without need for isolation from the ATMega32.
    The single LED driver is used to light the LEDs on the secondary matrix as well
    since this does not seem to have much influence in the final design requirements.
    [cherry_proto_circuit.sch, key_matrix.sch, led_driver.sch, secondary_matrix.sch]
2019-01-27 Add secondary keyboard matrix design.
    [LDO.sch, cherry_proto_circuit.sch, cherry_proto_usb.sch, secondary_matrix.sch]
2019-05-04 Add prototype backlight control for is3733.
    LED configuration is triggered when the serial is connected.
2019-06-08 Bind backlight actions to keys.
    Move the backlight control logic in the keyboard matrix handling module.
    Add time to tick conversion logic for timer 3.
2019-06-09 Implement breathing modes for leds.
    Key (1,0) is used to cycle through leds.
    Key (1,1) is used to trigger a scan of all the colors in 0x20 increments on the selected led.
    Key (0,0) is used to trigger a keyboard half scan of all the colors in 0x20 increments.
    Key (0,0) must first be pressed to trigger the open/short detection.
    [backlight.c, backlight.h, matrix.c]
