qwattash/keyboard_tester/(notices)

Notices in the files:
pcb/cherry_breakout/cherry_breakout.kicad_pcb:
© qwattash
